austinscreations/IOTAP/Hardware/cm4 IOTAP/README.md

kicad files
=====================

These kicad files are of the orginal design done by jon oxer.

I (austins_creations) got excited about a cm4 design. so put together this schematic
that should be all the needed elements to make the cm4 wifi IOT AP project work.
added the DIY POE switcher
added the ability for the cm4 to know which power mode is in use

pcb veiw is left mostly blank for jon to do routing on stream (if he so chooses to use the files)
but pcb veiw does have the elements from the last design copies over and converted for kicad use to ensure DRC passes

Credits
-------
 * Jonathan Oxer <jon@oxer.com.au>
 * Tony Smith
 * Austin's Creations <https://www.austinscreations.ca/>
 * All the folks watching and commenting on the streams!

License
-------
Copyright 2020-2022 SuperHouse Automation Pty Ltd  www.superhouse.tv  

The hardware portion of this project is licensed under the TAPR Open
Hardware License (www.tapr.org/OHL). The "license" folder within this
repository contains a copy of this license in plain text format.

The software portion of this project is licensed under the Simplified
BSD License. The "licence" folder within this project contains a
copy of this license in plain text format.
