austinscreations/IOTAP/Hardware/cm4 IOTAP/schematic.jpg

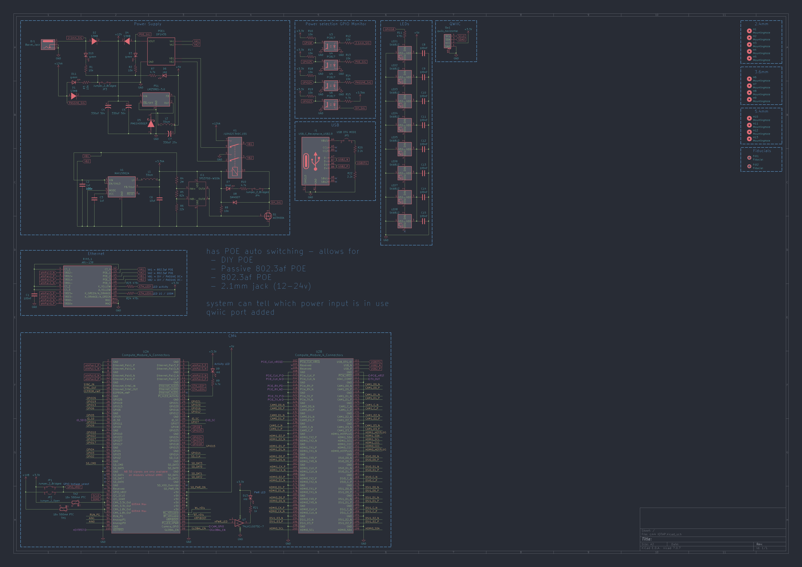
Hardware/cm4 IOTAP/schematic.jpg
