austinscreations/IOTAP/Hardware/cm4 IOTAP/cm4 IOTAP.kicad_pcb

## KiCad design Hardware/cm4 IOTAP/cm4 IOTAP.kicad_pcb (2023-10-08)

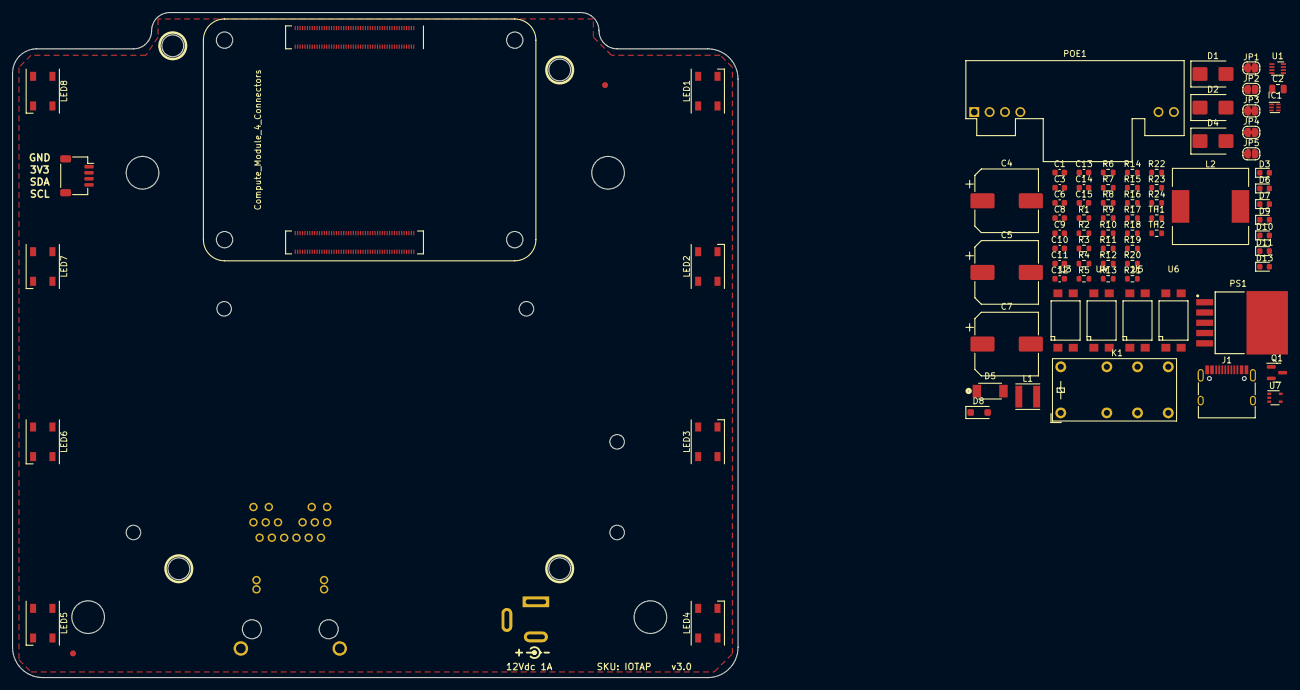
[picture p2: board cm4 IOTAP.kicad_pcb from above]

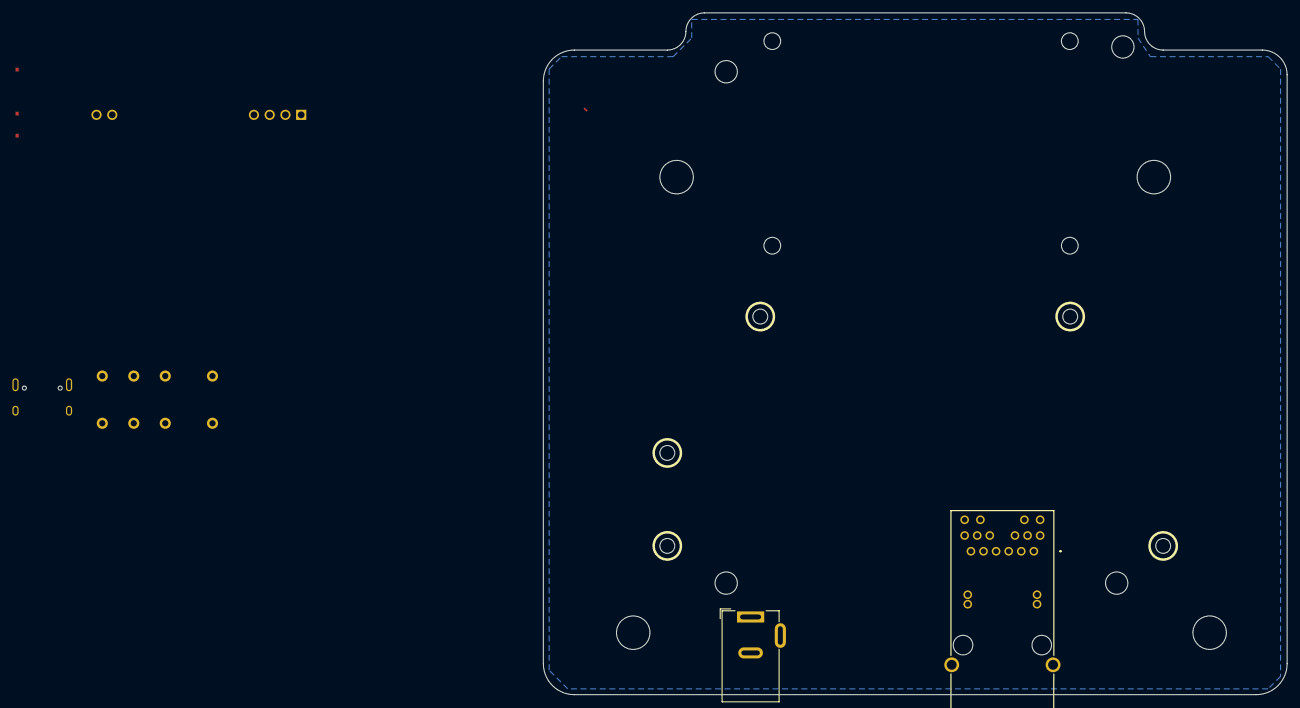
[picture p3: board cm4 IOTAP.kicad_pcb from below]

Board: 2 copper layers, 120.0 x 110.0 mm, 99 parts (2 on the bottom side), 72 nets.

Parts:
BJ1: Barrel_Jack; Barrel Jack
C1, C8, C9, C10, C11, C12, C13, C14, C15: 100nF; C_0603_1608Metric
C2: 1uf; C_0805_2012Metric
C3: 1uf; C_0603_1608Metric
C4, C5: 330uF 50v; CP_Elec_10x10
C6: 10uf; C_0603_1608Metric
C7: 330uF 25v; CP_Elec_10x10
D1, D2, D4: S3MB; D_SMB
D3, D10, D11: green; LED_0603_1608Metric
D5: PMEG4050EP; PMEG3050EP
D6, D9, D13: red; LED_0603_1608Metric
D7: blue; LED_0603_1608Metric
D8: SM4007; D_SOD-123F
FID1, FID2: Fiducial; Fiducial_1mm_Mask3mm
H1, H2, H3, H4, H5: MountingHole; MountingHole_2.5mm
H6, H7, H8, H9: MountingHole; MountingHole_3.5mm
H10, H11, H12, H13: MountingHole; MountingHole_5.3mm_M5
IC1: TPS3700-WSON; WSON-6_1.5x1.5mm_P0.5mm
J1: USB_C_Receptacle_USB2.0; USB_C_Receptacle_HRO_TYPE-C-31-M-12
JP1, JP3, JP4: Jumper_2_Bridged; SolderJumper-2_P1.3mm_Bridged_RoundedPad1.0x1.5mm
JP2: Jumper_2_Open; SolderJumper-2_P1.3mm_Open_RoundedPad1.0x1.5mm
JP5: USB OTG MODE; SolderJumper-2_P1.3mm_Open_RoundedPad1.0x1.5mm
K1: J104D2C3VDC.15S; Relay_DPDT_Finder_30.22
L1: 33UH; L_Vishay_IFSC-1515AH_4x4x1.8mm
L2: 33UH; 12x12x8 inductor
LED1, LED2, LED3, LED4, LED5, LED6, LED7, LED8: SK6812; LED_SK6812_PLCC4_5.0x5.0mm_P3.2mm
POE1: DP1435
PS1: LM2596S-5.0; LM2596S
Q1: AO3400A; SOT-23
Qw1: qwiic_horizontal; qwiic horizontal
R1, R2, R3, R8, R12, R13, R14, R16, R17, R18, R19: 10k; R_0603_1608Metric
R4: 2M; R_0603_1608Metric
R5: 62k; R_0603_1608Metric
R6: 22k; R_0603_1608Metric
R7, R9, R10, R15: 4.7k; R_0603_1608Metric
R11, R23, R24: 470r; R_0603_1608Metric
R20, R22: 2.2k; R_0603_1608Metric
R21: 1k; R_0603_1608Metric
RJ45_1: ARJ-139; ARJ139
TH1, TH2: 16v 500mA PTC; R_0603_1608Metric
U1: MAX15062A; DFN-8_2x2mm_P0.5mm
U2: Compute_Module_4_Connectors; Raspberry-Pi-4-Compute-Module
U3, U4, U5, U6: PC817; smd4
U7: 74LVC1G07SE-7; SOT-353_SC-70-5

Connections:
2.1mm_SIG: BJ1.1, D2.1 (K), D10.2 (A), R12.2
+1V8: JP2.1 (A), TH1.1
+3.3V: D9.2 (A), D13.2 (A), JP1.1 (A), Qw1.2 (VCC), R16.1, R17.1, R18.1, R19.1, RJ45_1.18 (A_YELLOW), RJ45_1.20 (K_ORANGE/A_GREEN), TH2.1, U7.5 (VCC)
+3.3VA: C6.1, D7.2 (A), D8.1 (K), IC1.2 (VDD), L1.2, R8.1, R15.2, U1.4 (FB/Vout)
+5V: C7.1, C8.2, C9.2, C10.2, C11.2, C12.2, C13.2, C14.2, C15.2, D6.2 (A), L2.2, LED1.3 (VDD), LED2.3 (VDD), LED3.3 (VDD), LED4.3 (VDD), LED5.3 (VDD), LED6.3 (VDD), LED7.3 (VDD), LED8.3 (VDD), PS1.4 (FB), U2.77 (+5V), U2.79 (+5V), U2.81 (+5V), U2.83 (+5V), U2.85 (+5V), U2.87 (+5V)
+12V: C4.1, C5.1, D1.2 (A), D2.2 (A), D4.2 (A), PS1.1 (VIN)
/nPWR_LED: U2.95 (~PI_LED_nPWR), U7.2
DIY_SIG: D8.2 (A), JP4.2 (B), Q1.3 (D), U6.2
ETH_LEDG: R24.2, U2.17 (~Ethernet_nLED2)
ETH_LEDY: R23.2, U2.15 (~Ethernet_nLED3)
GND: BJ1.2, BJ1.3, C1.2, C4.2, C5.2, C7.2, C8.1, C9.1, C10.1, C11.1, C12.1, C13.1, C14.1, C15.1, D5.2 (A), J1.A1 (GND), J1.A12 (GND), J1.B1 (GND), J1.B12 (GND), J1.S1 (SHIELD), JP3.2 (B), LED1.1 (VSS), LED2.1 (VSS), LED3.1 (VSS), LED4.1 (VSS), LED5.1 (VSS), LED6.1 (VSS), LED7.1 (VSS), LED8.1 (VSS), POE1.GND, PS1.3 (GND), PS1.5 (~ON/OFF), Qw1.1 (GND), Qw1.MP, R22.1, RJ45_1.MH1, RJ45_1.MH2, U2.1 (GND), U2.2 (GND), U2.7 (GND), U2.8 (GND), U2.13 (GND), U2.14 (GND), U2.22 (GND), U2.23 (GND), U2.32 (GND), U2.33 (GND), U2.42 (GND), U2.43 (GND), U2.52 (GND), U2.53 (GND), U2.59 (GND), U2.60 (GND), U2.65 (GND), U2.66 (GND), U2.71 (GND), U2.74 (GND), U2.98 (GND), U2.107 (GND), U2.108 (GND), U2.113 (GND), U2.114 (GND), U2.119 (GND), U2.120 (GND), U2.125 (GND), U2.126 (GND), U2.131 (GND), U2.132 (GND), U2.137 (GND), U2.138 (GND), U2.144 (GND), U2.150 (GND), U2.155 (GND), U2.156 (GND), U2.161 (GND), U2.162 (GND), U2.167 (GND), U2.168 (GND), U2.173 (GND), U2.174 (GND), U2.179 (GND), U2.180 (GND), U2.185 (GND), U2.186 (GND), U2.191 (GND), U2.192 (GND), U2.197 (GND), U2.198 (GND), U3.2, U3.3, U4.2, U4.3, U5.2, U5.3, U6.3, U7.3 (GND)
GPIO8: R16.2, U2.39 (GPIO8), U3.4
GPIO18: R11.1, U2.49 (GPIO18)
GPIO23: R19.2, U2.47 (GPIO23), U6.4
GPIO24: R18.2, U2.45 (GPIO24), U5.4
GPIO25: R17.2, U2.41 (GPIO25), U4.4
GPIO_VREF: JP1.2 (B), JP2.2 (B), U2.78 (GPIO_VREF)
unnamed: D3.1 (K), R2.1
unnamed: D5.1 (K), L2.1, PS1.2 (OUT)
unnamed: D6.1 (K), R7.1
unnamed: D7.1 (K), R10.1
unnamed: D9.1 (K), R9.1
unnamed: D10.1 (K), R1.1
unnamed: D11.1 (K), R3.1
unnamed: D13.1 (K), R21.1
unnamed: IC1.4 (INA+), R4.2, R5.1
unnamed: IC1.3 (INB-), R5.2, R6.1
unnamed: IC1.1 (OUTB), IC1.6 (OUTA), Q1.1 (G), R8.2
unnamed: JP3.1 (A), R1.2, R2.2, R3.2, R7.2
unnamed: JP4.1 (A), R10.2
unnamed: JP5.1 (A), R20.1
unnamed: J1.A4 (VBUS), J1.A9 (VBUS), J1.B4 (VBUS), J1.B9 (VBUS), JP5.2 (B)
unnamed: LED1.2 (DIN), R11.2
unnamed: LED1.4 (DOUT), LED2.2 (DIN)
unnamed: LED2.4 (DOUT), LED3.2 (DIN)
unnamed: LED3.4 (DOUT), LED4.2 (DIN)
unnamed: LED4.4 (DOUT), LED5.2 (DIN)
unnamed: LED5.4 (DOUT), LED6.2 (DIN)
unnamed: LED6.4 (DOUT), LED7.2 (DIN)
unnamed: LED7.4 (DOUT), LED8.2 (DIN)
unnamed: R12.1, U3.1
unnamed: R13.1, U4.1
unnamed: R14.1, U5.1
unnamed: R15.1, U6.1
unnamed: R21.2, U7.4
unnamed: C1.1, RJ45_1.1 (CT_1), RJ45_1.6 (CT_2), RJ45_1.7 (CT_3), RJ45_1.12 (CT_4)
unnamed: R24.1, RJ45_1.19 (K_GREEN/A_ORANGE)
unnamed: R23.1, RJ45_1.17 (K_YELLOW)
unnamed: TH1.2, U2.88 (CM4_1.8V_Out), U2.90 (CM4_1.8V_Out)
unnamed: TH2.2, U2.84 (CM4_3.3V_Out), U2.86 (CM4_3.3V_Out)
unnamed: L1.1, U1.8 (LX)
unnamed: C3.1, U1.3 (VCC)
unnamed: R9.2, U2.21 (~Pi_nLED_Activity)
PASSIVE_SIG: D1.1 (K), D11.2 (A), R14.2
POE_SIG: D3.2 (A), D4.1 (K), POE1.VOUT, R13.2
SCL0: Qw1.4 (SCL), U2.80 (I2C_SCL0)
SDA0: Qw1.3 (SDA), U2.82 (I2C_SDA0)
USB2_N: J1.A7 (D-), J1.B7 (D-), U2.103 (USB_N)
USB2_P: J1.A6 (D+), J1.B6 (D+), U2.105 (USB_P)
USBOTG: R20.2, R22.2, U2.101 (USB_OTG_ID)
VA1: POE1.VA1, RJ45_1.13 (POE_1)
VA2: POE1.VA2, RJ45_1.14 (POE_2)
VB1: C2.1, R4.1, RJ45_1.15 (POE_3), U1.1 (VIN), U1.2 (EN/UVLO)
VB2: C2.2, C3.2, C6.2, IC1.5 (GND), Q1.2 (S), R6.2, RJ45_1.16 (POE_4), U1.5 (MODE), U1.7 (GND)
ethPair0_N: RJ45_1.10 (TRD0-), U2.10 (Ethernet_Pair0_N)
ethPair0_P: RJ45_1.11 (TRD0+), U2.12 (Ethernet_Pair0_P)
ethPair1_N: RJ45_1.5 (TRD1-), U2.6 (Ethernet_Pair1_N)
ethPair1_P: RJ45_1.4 (TRD1+), U2.4 (Ethernet_Pair1_P)
ethPair2_N: RJ45_1.2 (TRD2-), U2.9 (Ethernet_Pair2_N)
ethPair2_P: RJ45_1.3 (TRD2+), U2.11 (Ethernet_Pair2_P)
ethPair3_N: RJ45_1.9 (TRD3-), U2.5 (Ethernet_Pair3_N)
ethPair3_P: RJ45_1.8 (TRD3+), U2.3 (Ethernet_Pair3_P)
