austinscreations/IOTAP/Hardware/kicad pi zero/IOTAP.kicad_pcb

## KiCad design Hardware/kicad pi zero/IOTAP.kicad_pcb (2023-10-08)

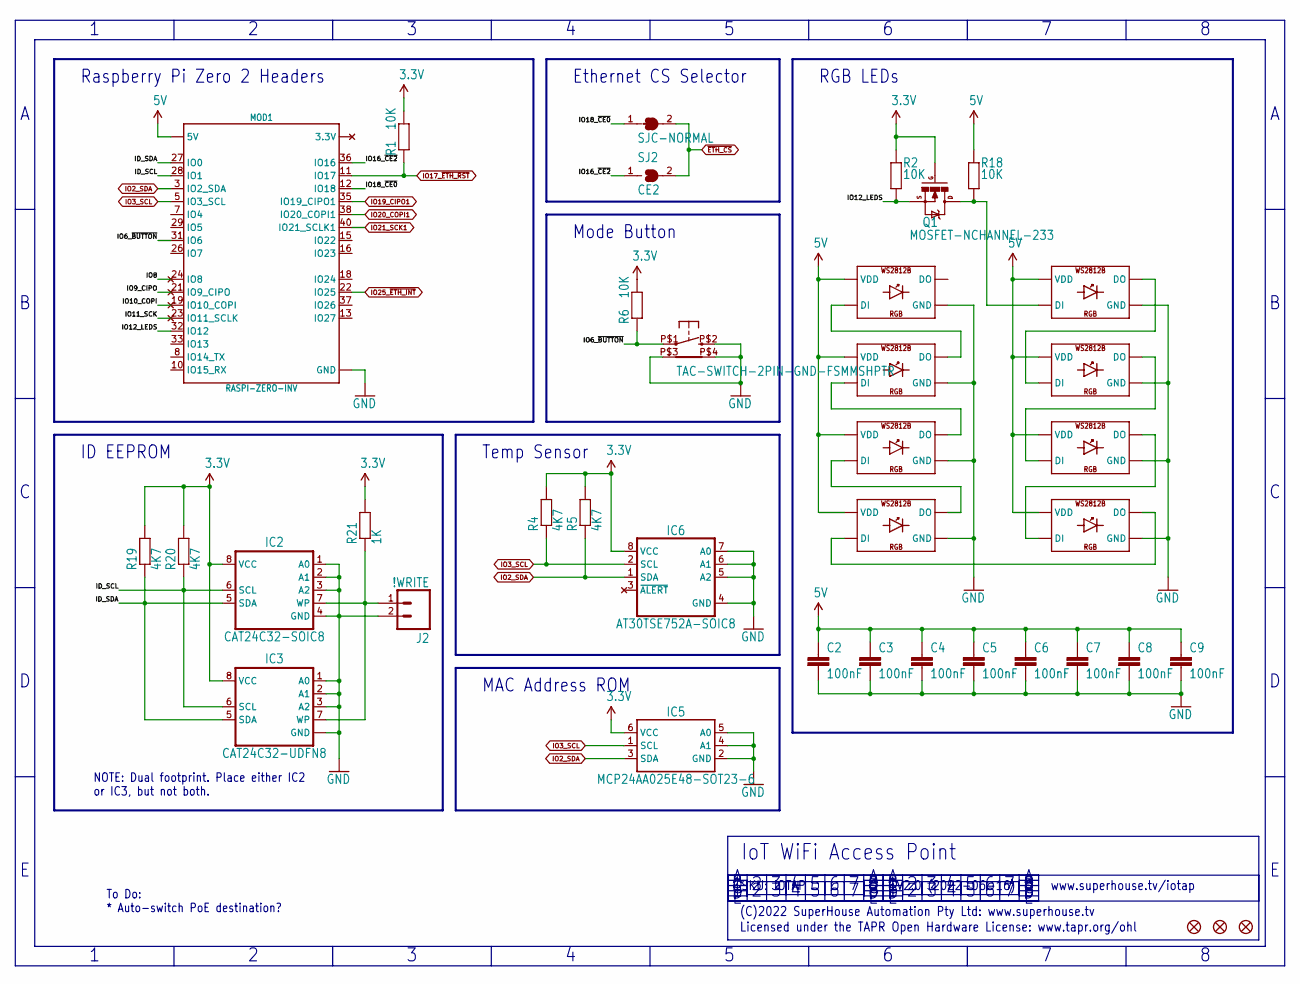
[picture p4: schematic IOTAP_1.kicad_sch]

Parts:
C2, C3, C4, C5, C6, C7, C8, C9: 100nF; C0603
FID1, FID2, FID3: FIDUCIAL1X2.5; FIDUCIAL-1X2.5
IC2: CAT24C32-SOIC8; SOIC8
IC3: CAT24C32-UDFN8; UDFN8
IC5: MCP24AA025E48-SOT23-6; SOT23-6
IC6: AT30TSE752A-SOIC8; SOIC8
J2: !WRITE; 1X02
LED1, LED2, LED3, LED4, LED5, LED6, LED7, LED8: WS2812B5050; WS2812B
MOD1: RASPI-ZERO-INV; RPI-ZERO-INV
Q1: MOSFET-NCHANNEL-233; SOT23-3
R1, R2, R6, R18: 10K; R0603
R4, R5, R19, R20: 4K7; R0603
R21: 1K; R0603
SJ1: SJC-NORMAL; SJC
SJ2: CE2; SJ
SW1: TAC-SWITCH-2PIN-GND-FSMMSHPTR; TC-120V

Connections:
3.3V: IC2.8 (VCC), IC3.8 (VCC), IC5.6 (VCC), IC6.8 (VCC), Q1.1 (G), R1.2, R2.2, R4.2, R5.2, R6.2, R19.2, R20.2, R21.2; also elsewhere on the board
5V: C2.1, C3.1, C4.1, C5.1, C6.1, C7.1, C8.1, C9.1, LED1.1-VDD (VDD), LED2.1-VDD (VDD), LED3.1-VDD (VDD), LED4.1-VDD (VDD), LED5.1-VDD (VDD), LED6.1-VDD (VDD), LED7.1-VDD (VDD), LED8.1-VDD (VDD), MOD1.2 (5V), MOD1.4 (5V), R18.2; also elsewhere on the board
GND: C2.2, C3.2, C4.2, C5.2, C6.2, C7.2, C8.2, C9.2, IC2.1 (A0), IC2.2 (A1), IC2.3 (A2), IC2.4 (GND), IC3.1 (A0), IC3.2 (A1), IC3.3 (A2), IC3.4 (GND), IC3.PAD (GND), IC5.2 (GND), IC5.4 (A1), IC5.5 (A0), IC6.4 (GND), IC6.5 (A2), IC6.6 (A1), IC6.7 (A0), J2.2, LED1.3-GND (GND), LED2.3-GND (GND), LED3.3-GND (GND), LED4.3-GND (GND), LED5.3-GND (GND), LED6.3-GND (GND), LED7.3-GND (GND), LED8.3-GND (GND), MOD1.6 (GND), MOD1.9 (GND), MOD1.14 (GND), MOD1.20 (GND), MOD1.25 (GND), MOD1.30 (GND), MOD1.34 (GND), MOD1.39 (GND), SW1.P$2 (2), SW1.P$3 (TAB1), SW1.P$4 (TAB2); also elsewhere on the board
ID_SCL: IC2.6 (SCL), IC3.6 (SCL), MOD1.28 (IO1), R20.1
ID_SDA: IC2.5 (SDA), IC3.5 (SDA), MOD1.27 (IO0), R19.1
IO2_SDA: IC5.3 (SDA), IC6.1 (SDA), MOD1.3 (IO2_SDA), R5.1; also elsewhere on the board
IO3_SCL: IC5.1 (SCL), IC6.2 (SCL), MOD1.5 (IO3_SCL), R4.1; also elsewhere on the board
IO6_~BUTTON: MOD1.31 (IO6), R6.1, SW1.P$1 (1)
IO8: MOD1.24 (IO8)
IO9_CIPO: MOD1.21 (IO9_CIPO)
IO10_COPI: MOD1.19 (IO10_COPI)
IO11_SCK: MOD1.23 (IO11_SCLK)
IO12_LEDS: MOD1.32 (IO12), Q1.2 (S), R2.1
IO16_~CE2: MOD1.36 (IO16), SJ2.1
IO17_~ETH_RST: MOD1.11 (IO17), R1.1; also elsewhere on the board
IO18_~CE0: MOD1.12 (IO18), SJ1.1
IO19_CIPO1: MOD1.35 (IO19_CIPO1); also elsewhere on the board
IO20_COPI1: MOD1.38 (IO20_COPI1); also elsewhere on the board
IO21_SCK1: MOD1.40 (IO21_SCLK1); also elsewhere on the board
IO25_~ETH_INT: MOD1.22 (IO25); also elsewhere on the board
LEDS: LED1.4-DIN (DI), Q1.3 (D), R18.1
unnamed: IC2.7 (WP), IC3.7 (WP), J2.1, R21.1
unnamed: LED4.2-DOUT (DO), LED5.4-DIN (DI)
unnamed: LED5.2-DOUT (DO), LED6.4-DIN (DI)
unnamed: LED6.2-DOUT (DO), LED7.4-DIN (DI)
unnamed: LED7.2-DOUT (DO), LED8.4-DIN (DI)
unnamed: LED1.2-DOUT (DO), LED2.4-DIN (DI)
unnamed: LED2.2-DOUT (DO), LED3.4-DIN (DI)
unnamed: LED3.2-DOUT (DO), LED4.4-DIN (DI)
~ETH_CS: SJ1.2, SJ2.2; also elsewhere on the board

Notes on the sheet:
RGB LEDs
ID EEPROM
(C)2022 SuperHouse Automation Pty Ltd: www.superhouse.tv
MAC Address ROM
SKU: IOTAP
NOTE: Dual footprint. Place either IC2 or IC3, but not both.
To Do: * Auto-switch PoE destination?
Temp Sensor
Licensed under the TAPR Open Hardware License: www.tapr.org/ohl
Mode Button
Ethernet CS Selector
IoT WiFi Access Point
www.superhouse.tv/iotap
V2.0 (2022-06-16)
Raspberry Pi Zero 2 Headers

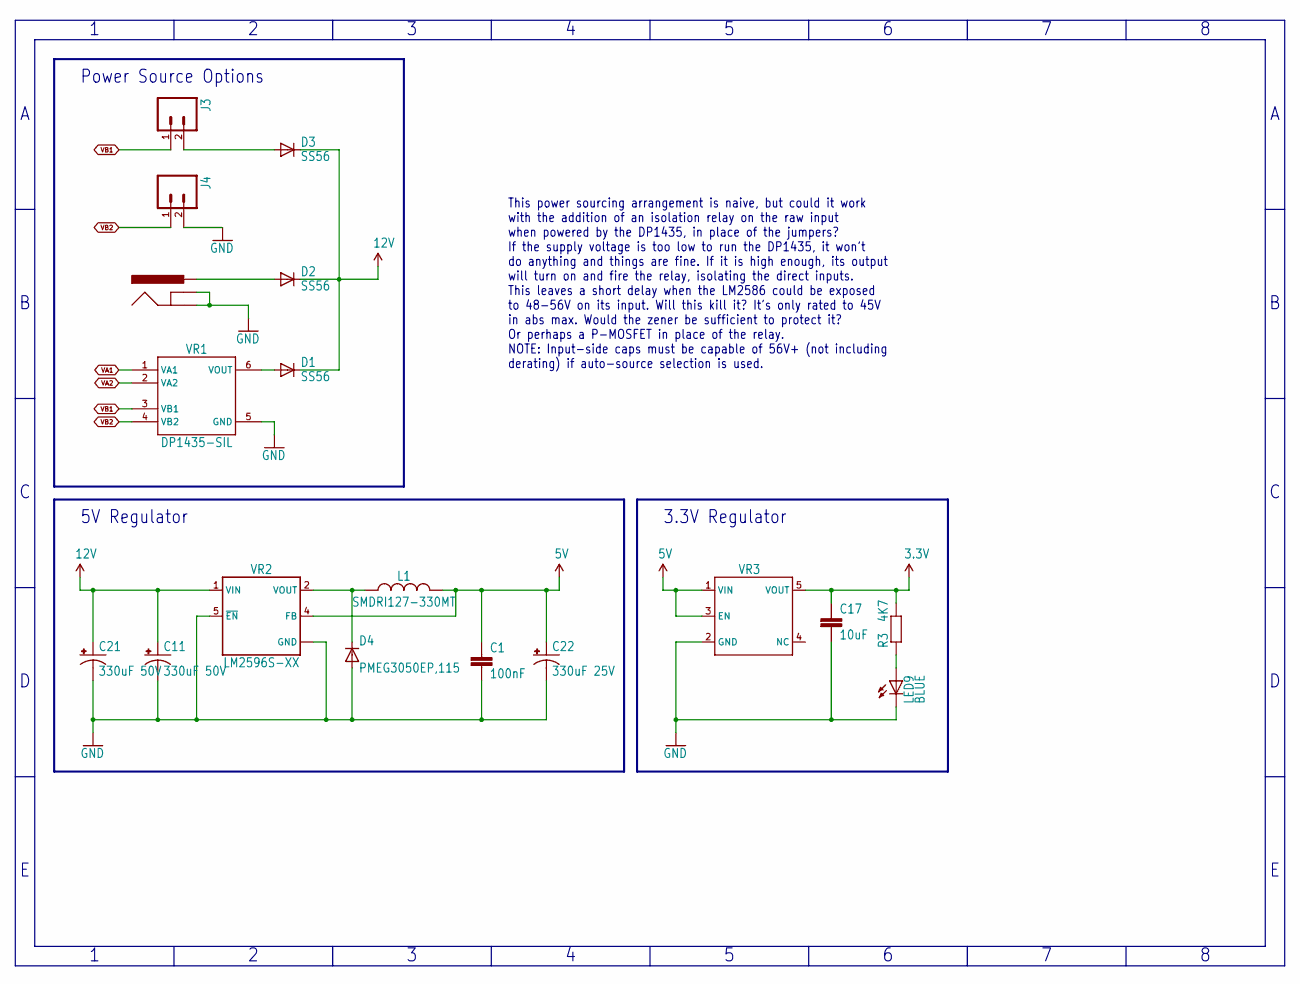
[picture p5: schematic IOTAP_3.kicad_sch]

Parts:
C1: 100nF; C0603
C11, C21: 330uF 50V; PANASONIC_G
C17: 10uF; C0805
C22: 330uF 25V; PANASONIC_G
D1, D2, D3: SS56; SMA-DIODE
D4: PMEG3050EP,115; SOD-128
J1: POWER_JACK-SLOTS; POWER_JACK_SLOTS
J3, J4: M02-PIN-RA; 1X02-P-RA
L1: SMDRI127-330MT; INDPM120120X800N
LED9: BLUE; LED-0603
R3: 4K7; R0603
VR1: DP1435-SIL; DP1435
VR2: LM2596S-XX; TO170P1435X465-6N
VR3: AP2112KSOT25; SOT23-5

Connections:
3.3V: C17.1, R3.2, VR3.5 (VOUT); also elsewhere on the board
5V: C1.1, C22.+, L1.2, VR2.4 (FB), VR3.1 (VIN), VR3.3 (EN); also elsewhere on the board
12V: C11.+, C21.+, D1.C, D2.C, D3.C, VR2.1 (VIN)
GND: C1.2, C11.-, C17.2, C21.-, C22.-, D4.2 (A), J1.GND, J1.GNDBREAK, J4.2, LED9.C, VR1.5 (GND), VR2.3 (GND), VR2.5 (~EN), VR2.6 (GND), VR3.2 (GND); also elsewhere on the board
unnamed: D3.A, J3.2
unnamed: D4.1 (C), L1.1, VR2.2 (VOUT)
unnamed: LED9.A, R3.1
unnamed: D2.A, J1.PWR
unnamed: D1.A, VR1.6 (VOUT)
VA1: VR1.1 (VA1); also elsewhere on the board
VA2: VR1.2 (VA2); also elsewhere on the board
VB1: J3.1, VR1.3 (VB1); also elsewhere on the board
VB2: J4.1, VR1.4 (VB2); also elsewhere on the board

Notes on the sheet:
This power sourcing arrangement is naive, but could it work with the addition of an isolation relay on the raw input when powered by the DP1435, in place of the jumpers? If the supply voltage is too low to run the DP1435, it won't do anything and things are fine. If it is high enough, its output wi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
5V Regulator
Power Source Options
3.3V Regulator

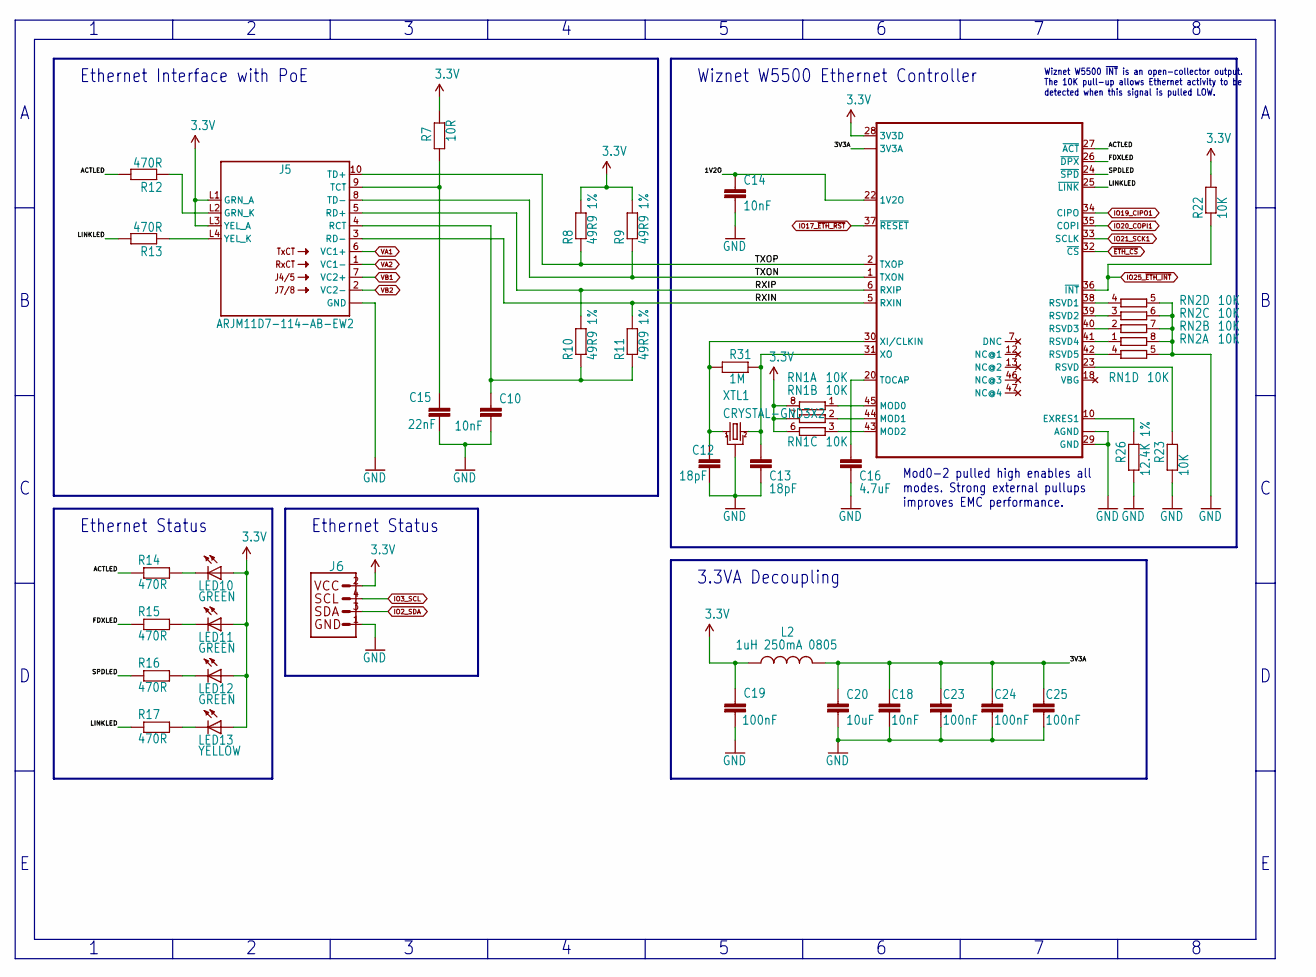
[picture p6: schematic IOTAP_2.kicad_sch]

Parts:
C10, C14, C18: 10nF; C0603
C12, C13: 18pF; C0603
C15: 22nF; C0603
C16: 4.7uF; C0603
C19, C23, C24, C25: 100nF; C0603
C20: 10uF; C0805
IC4: W5500-LQFP; LQFP48
J5: ARJM11D7-114-AB-EW2; ARJM11D7114ABEW2
J6: QWIICJS-1MM; 1X04_QWIIC_1MM_RA
L2: 1uH 250mA 0805; L2012C
LED10, LED11, LED12: GREEN; LED-0603
LED13: YELLOW; LED-0603
R7: 10R; R0603
R8, R9, R10, R11: 49R9 1%; R0603
R12, R13, R14, R15, R16, R17: 470R; R0603
R22, R23: 10K; R0603
R26: 12.4K 1%; R0603
R31: 1M; R0603
RN1, RN2: 10K; CAY16
XTL1: CRYSTAL-GND3X2; CRYSTAL-SMD-3X2

Connections:
1V2O: C14.1, IC4.22 (1V2O)
3.3V: C19.1, IC4.28 (3V3D), J5.L1 (GRN_A), J5.L3 (YEL_A), J6.2, L2.1, LED10.A, LED11.A, LED12.A, LED13.A, R7.1, R8.2, R9.2, R22.2, RN1.6 (2), RN1.7 (2), RN1.8 (2); also elsewhere on the board
3V3A: C18.1, C20.1, C23.1, C24.1, C25.1, IC4.4 (3V3A), IC4.8 (3V3A), IC4.11 (3V3A), IC4.15 (3V3A), IC4.17 (3V3A), IC4.21 (3V3A), L2.2
ACTLED: IC4.27 (~ACT), R12.2, R14.1
FDXLED: IC4.26 (~DPX), R15.1
GND: C10.2, C12.2, C13.2, C14.2, C15.2, C16.2, C18.2, C19.2, C20.2, C23.2, C24.2, C25.2, IC4.3 (AGND), IC4.9 (AGND), IC4.14 (AGND), IC4.16 (AGND), IC4.19 (AGND), IC4.29 (GND), IC4.48 (AGND), J5.MH1 (GND), J5.MH2 (GND), J6.1, R23.2, R26.2, RN1.5 (2), RN2.5 (2), RN2.6 (2), RN2.7 (2), RN2.8 (2), XTL1.2 (GND), XTL1.4 (GND); also elsewhere on the board
IO2_SDA: J6.3; also elsewhere on the board
IO3_SCL: J6.4; also elsewhere on the board
IO17_~ETH_RST: IC4.37 (~RESET); also elsewhere on the board
IO19_CIPO1: IC4.34 (CIPO); also elsewhere on the board
IO20_COPI1: IC4.35 (COPI); also elsewhere on the board
IO21_SCK1: IC4.33 (SCLK); also elsewhere on the board
IO25_~ETH_INT: IC4.36 (~INT), R22.1; also elsewhere on the board
LINKLED: IC4.25 (~LINK), R13.2, R17.1
unnamed: J5.L4 (YEL_K), R13.1
unnamed: J5.L2 (GRN_K), R12.1
unnamed: C13.1, IC4.31 (XO), R31.1, XTL1.3 (2)
unnamed: C10.1, J5.4 (RCT), R10.1, R11.1
unnamed: LED12.C, R16.2
unnamed: C12.1, IC4.30 (XI/CLKIN), R31.2, XTL1.1
unnamed: LED13.C, R17.2
unnamed: C16.1, IC4.20 (TOCAP)
unnamed: C15.1, J5.9 (TCT), R7.2
unnamed: IC4.10 (EXRES1), R26.1
unnamed: IC4.23 (RSVD), R23.1
unnamed: IC4.45 (MOD0), RN1.1
unnamed: IC4.44 (MOD1), RN1.2 (1)
unnamed: IC4.43 (MOD2), RN1.3 (1)
unnamed: IC4.42 (RSVD5), RN1.4 (1)
unnamed: IC4.41 (RSVD4), RN2.1
unnamed: IC4.40 (RSVD3), RN2.2 (1)
unnamed: IC4.39 (RSVD2), RN2.3 (1)
unnamed: IC4.38 (RSVD1), RN2.4 (1)
unnamed: LED11.C, R15.2
unnamed: LED10.C, R14.2
RXIN: IC4.5 (RXIN), J5.3 (RD-), R11.2
RXIP: IC4.6 (RXIP), J5.5 (RD+), R10.2
SPDLED: IC4.24 (~SPD), R16.1
TXON: IC4.1 (TXON), J5.8 (TD-), R9.1
TXOP: IC4.2 (TXOP), J5.10 (TD+), R8.1
VA1: J5.6 (VC1+); also elsewhere on the board
VA2: J5.1 (VC1-); also elsewhere on the board
VB1: J5.7 (VC2+); also elsewhere on the board
VB2: J5.2 (VC2-); also elsewhere on the board
~ETH_CS: IC4.32 (~CS); also elsewhere on the board

Notes on the sheet:
Ethernet Interface with PoE
3.3VA Decoupling
Ethernet Status
Wiznet W5500 ~{INT} is an open-collector output. The 10K pull-up allows Ethernet activity to be detected when this signal is pulled LOW.
Mod0-2 pulled high enables all modes. Strong external pullups improves EMC performance.
Wiznet W5500 Ethernet Controller

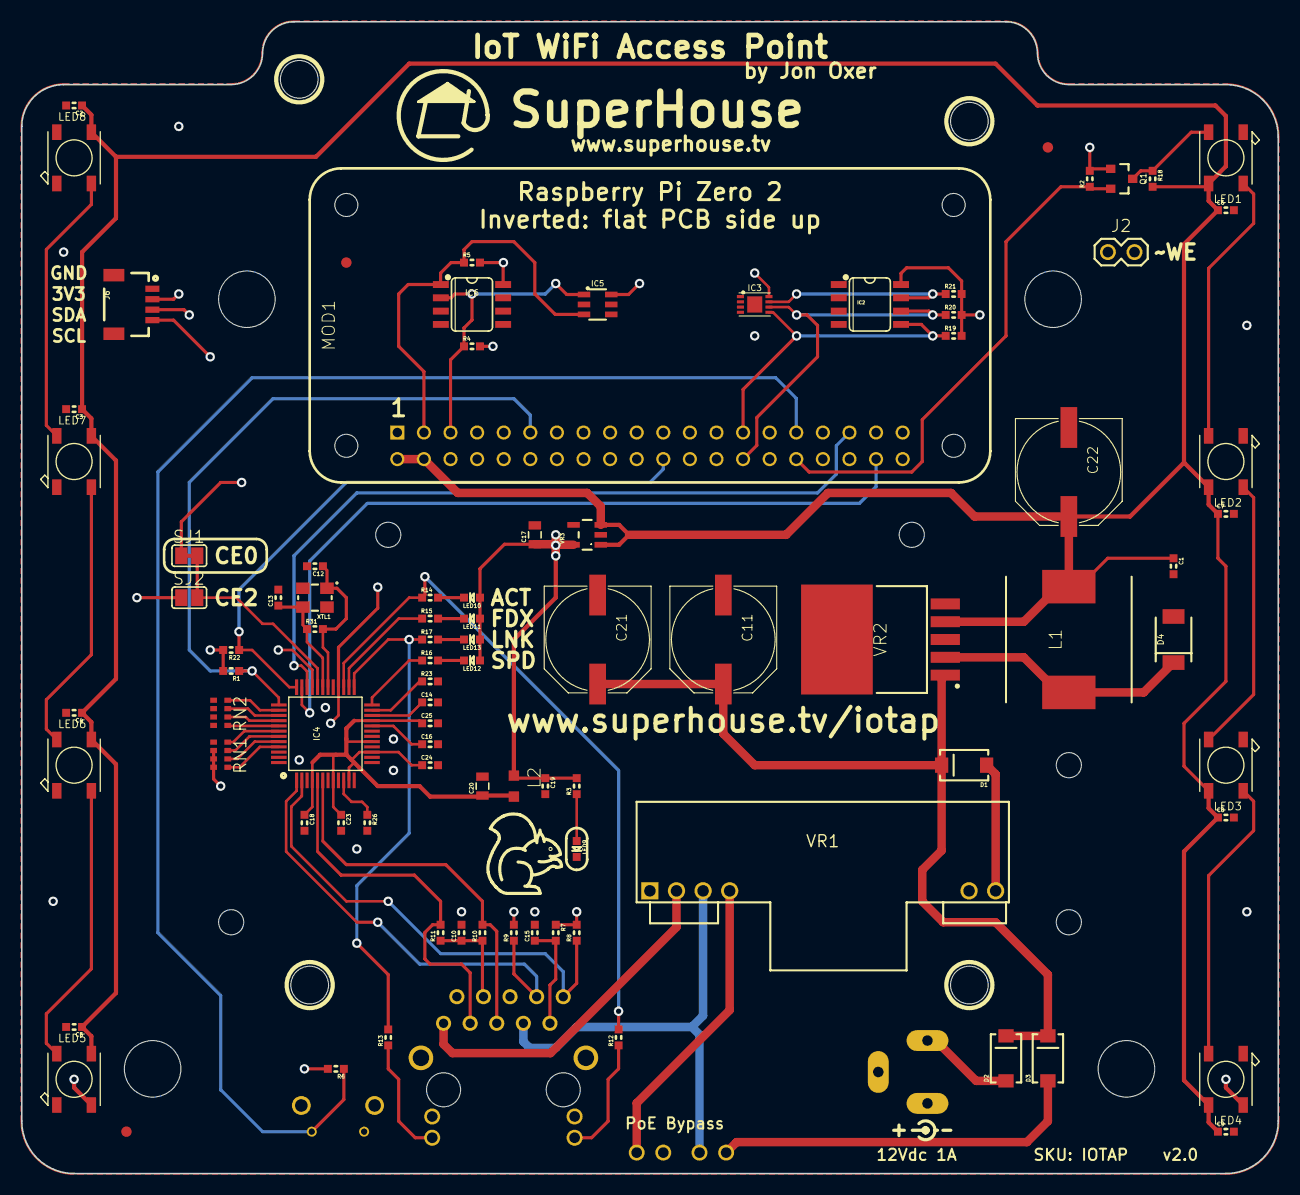
[picture p7: board IOTAP.kicad_pcb from above]

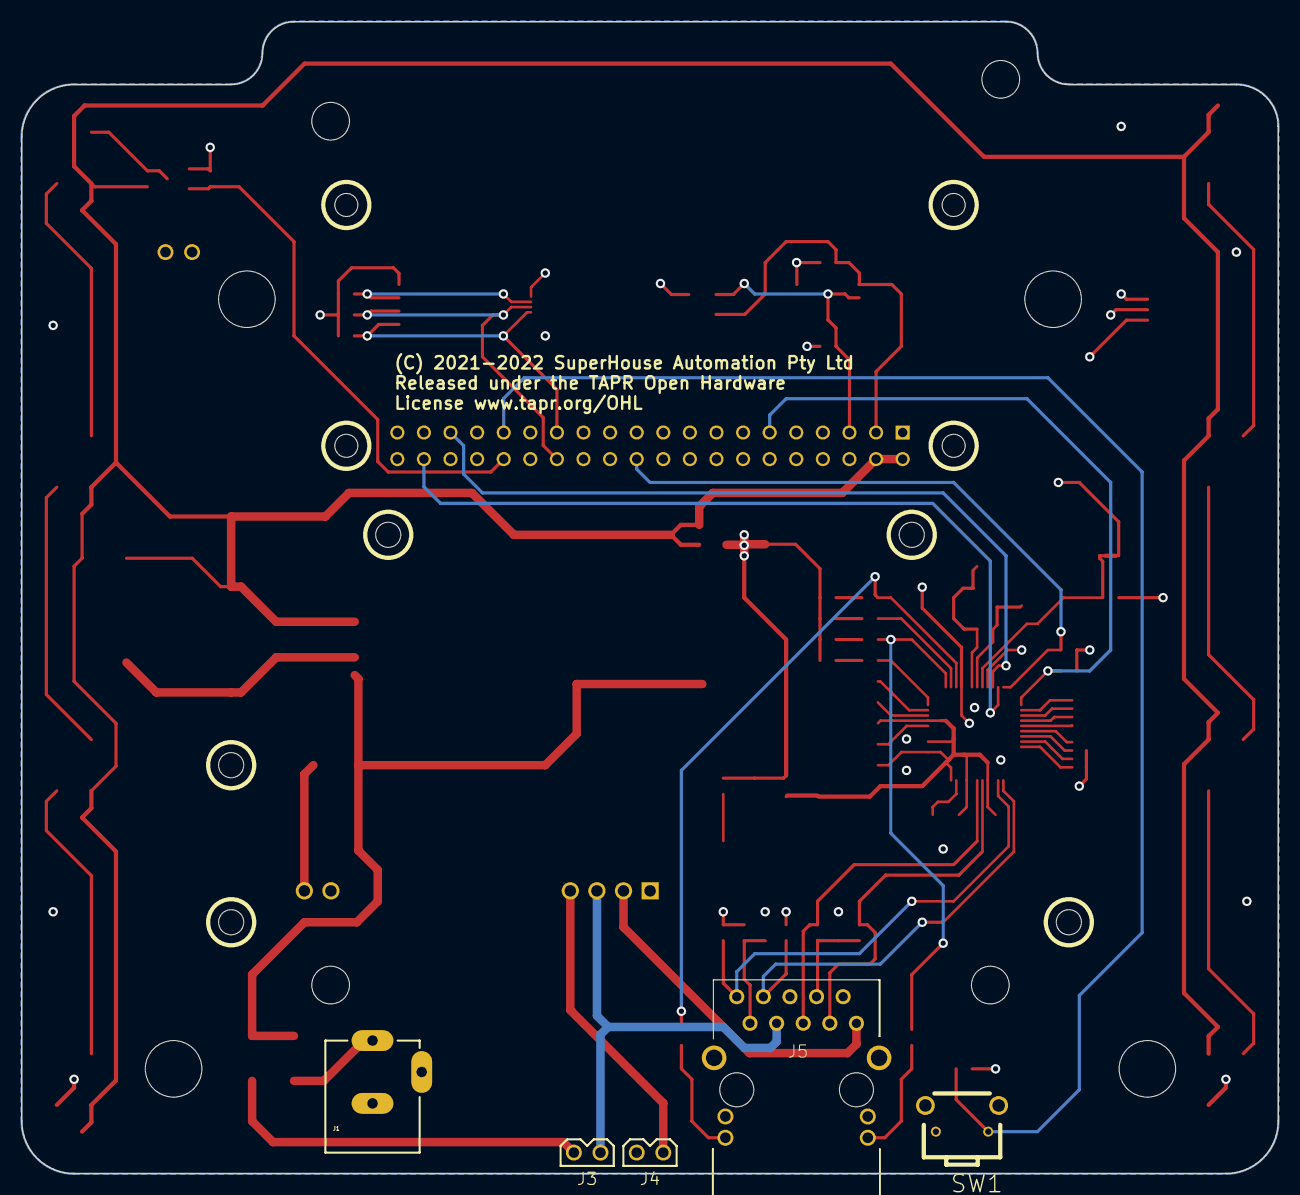
[picture p8: board IOTAP.kicad_pcb from below]

Board: 4 copper layers, 120.0 x 110.0 mm, 107 parts (5 on the bottom side), 67 nets.

Other parts of the board:
@HOLE0, @HOLE1, @HOLE2, @HOLE3, @HOLE4, @HOLE5, @HOLE6, @HOLE7, @HOLE8, @HOLE9, @HOLE10, @HOLE11, @HOLE12: (no value)
