austinscreations/IOTAP/(commit log)

2023-10-08 add converted kicad files
    [IOTAP.kicad_pcb, IOTAP.kicad_sch, IOTAP_1.kicad_sch, IOTAP_2.kicad_sch, IOTAP_3.kicad_sch]
2023-10-08 add cm4 design
    [cm4 IOTAP.kicad_pcb, cm4 IOTAP.kicad_sch]
2023-10-08 add resistors for Ethernet activity lights
    [cm4 IOTAP.kicad_pcb, cm4 IOTAP.kicad_sch]
2023-10-08 add schematic as an image
