austinscreations/IOTAP/(notices)

Notices in the files:
Hardware/kicad pi zero/IOTAP.kicad_pcb:
(C) 2021-2022 SuperHouse Automation Pty Ltd
